MattGrayYes/imac_g3_boards/schematics_and_pcbs/imac_g3_down_converter_board_adapter/imac_g3_down_converter_board_adapter.kicad_pcb

## KiCad design schematics_and_pcbs/imac_g3_down_converter_board_adapter/imac_g3_down_converter_board_adapter.kicad_pcb (2025-07-09)

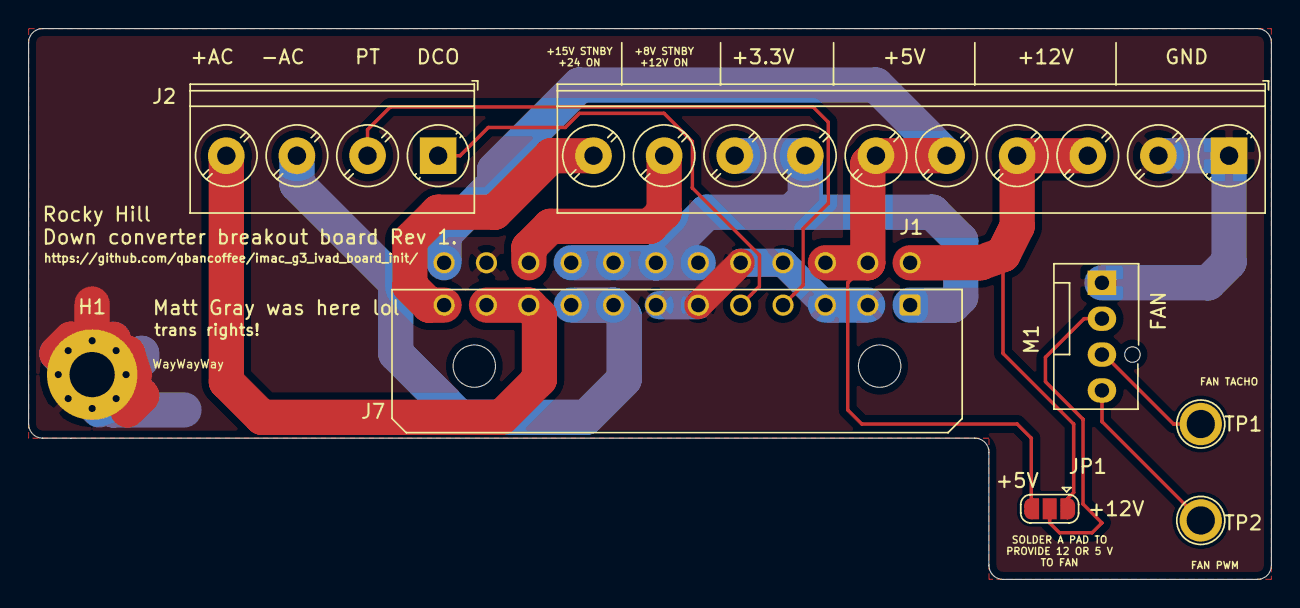
[picture p5: board imac_g3_down_converter_board_adapter.kicad_pcb from above]

Board: 2 copper layers, 88.0 x 39.0 mm, 8 parts (0 on the bottom side), 13 nets.

Parts:
H1: MountingHole_Pad; MountingHole_3.2mm_M3_Pad_Via
J1: Screw_Terminal_01x10; TerminalBlock_Phoenix_PT-1,5-10-5.0-H_1x10_P5.00mm_Horizont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
J2: Screw_Terminal_01x04; TerminalBlock_Phoenix_PT-1,5-4-5.0-H_1x04_P5.00mm_Horizontal
J7: Conn_02x12_Top_Bottom; Molex_Micro-Fit_3.0_43045-2400_2x12_P3.00mm_Horizontal
JP1: SolderJumper_3_Open; SolderJumper-3_P1.3mm_Open_RoundedPad1.0x1.5mm
M1: Fan_Tacho_PWM; FanPinHeader_1x04_P2.54mm_Vertical
TP1, TP2: TestPoint; TestPoint_Plated_Hole_D2.0mm

Connections:
/+3.3V: J1.7, J1.8, J7.1, J7.18, J7.19, J7.20, J7.21
/+5V: J1.5, J1.6, J7.14, J7.15, J7.24, JP1.3
/+8V_STANDBY_+12V_ON: J1.9, J7.22
/+12V: J1.3, J1.4, J7.13, JP1.1
/+15V_STANDBY_+24V_ON: J1.10, J7.12
/+AC: J2.4, J7.10, J7.11
/-AC: J2.3, J7.8, J7.9
/DCO: J2.1, J7.5
/GND: H1.1, J1.1, J1.2, J7.2, J7.3, J7.6, J7.7, J7.16, J7.17, J7.23, M1.1
/PT: J2.2, J7.4
/PWM: M1.4, TP2.1
/TACHO: M1.3, TP1.1
unnamed: JP1.2, M1.2
