MattGrayYes/imac_g3_boards/(commit log)

2025-07-09 Tidied up some code, changed values to work on my surface mount PCB and iMac Slot Loader, added new EDID.
    * Added new EDID, an edit of edid6 from oshimai to display "iMac G3 CRT" as the screen name
    * Added Copy/pasteable versions of edids as hex and base64
    * Changed BUFFER_LENGTH instructions to include MacOS path and an #ifndef, so the buffers are still 32 by default
    Added BUFFER_LENGTH check at compile
    * From [shuuryou's comment on issue 11](https://github.com/qbancoffee/imac_g3_ivad_board_init/issues/11#issuecomment-988259400)
    * Removed monitor property values as these variables never get updated
    * Added more status output on the Serial bus.
    * Removed vsyncDetect because it never det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
    [imacG3IvadInit.h, imacG3IvadInit.ino, ivad.h]
2025-07-09 graffittied silkscreens.
    [imac_g3_333mhz_slot_loading_J20_adapter_board.kicad_pcb, imac_g3_down_converter_board_adapter.kicad_pcb, imac_g3_slot_loading_J22_adapter_board.kicad_pcb]
